Sugarsplash/ece-capstone/README.md

# ece-capstone
Intel sponsored irrigation project.
