Sugarsplash/ece-capstone/docs/presentation.pdf

# Smart Irrigation ECE Capstone

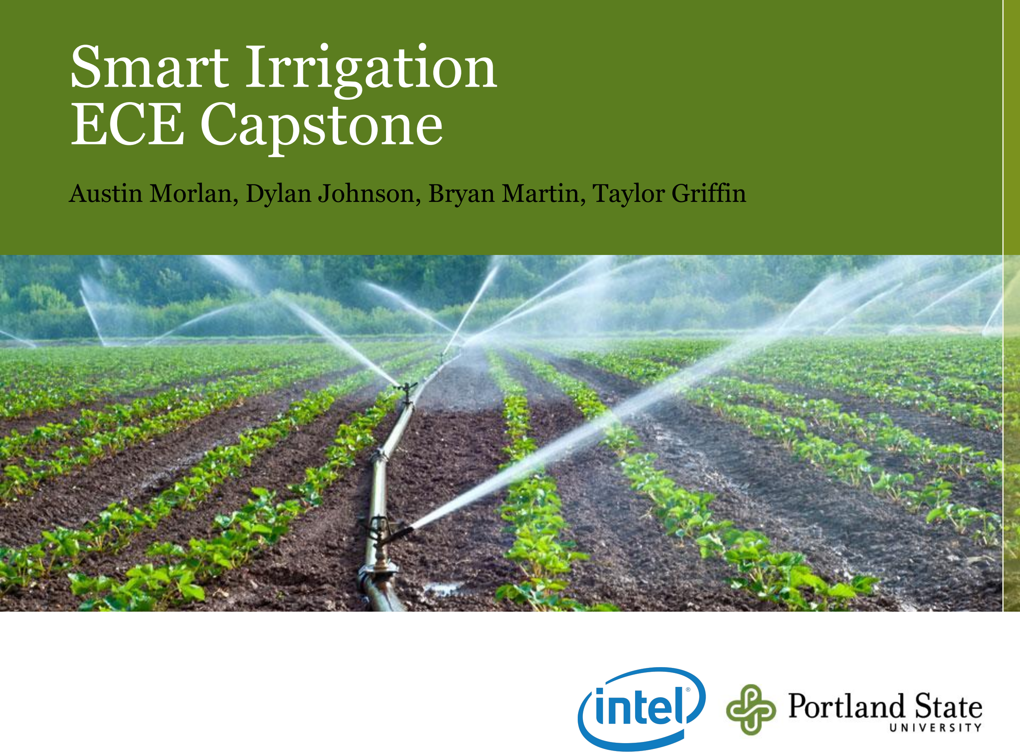
[picture p13: page 1]

Austin Morlan, Dylan Johnson, Bryan Martin, Taylor Griffin

# Problem

- Water is precious
- Current irrigation methods are wasteful
- Need more efficiency without lowering crop yield
- Existing irrigation controllers require:
- Frequent calibration
- Array of costly sensors
- Frequent sensor replacement

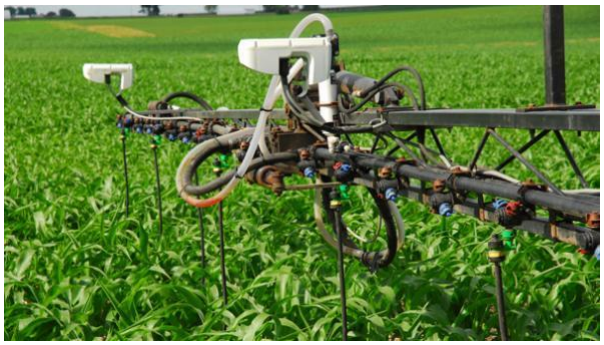
[picture p14: figure]

# Problem

### - There is a need for low cost, low maintenance controllers - Should work in any location, terrain, and local climate - Should contain few sensors for minimal cost

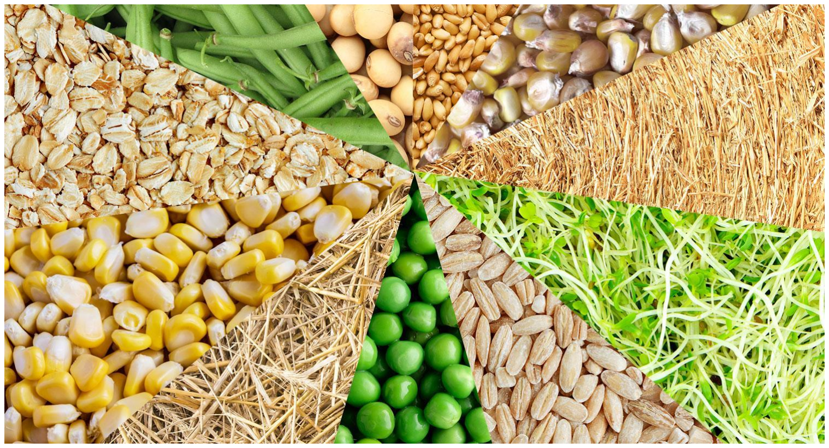
[picture p15: figure]

# Solution

- Water-budgeting & irrigation scheduling
- Tracks amount of water entering and leaving soil
- Evaporation of water from soil to environment
- Transpiration of water from crops to environment + Precipitation of water from environment to soil + Added water from water source

# Hargreaves Reduced-set Method

- Estimates evapotranspiration w/ ambient air temperature, latitude, and day of the year
- Requires two sensors: temperature and precipitation
- Latitude and calendar day supplied by app
- Calculates how much water has left soil
- Amount that has left is resupplied by water source

Irr - amount of water to be applied (mm) Eto - crop evapotranspiration (mm)
P - precipitation (mm)

# Device Technology

- MCU:
- BL600 - nRF51822 (Cortex M0) with smartBASIC added
- Sensors:
- Temperature, rain - for evapotranspiration algorithm
- Soil moisture - to check calculations against reality
- Flow - to measure amount of water distributed
- Enclosure
- Waterproof
- Snazzy

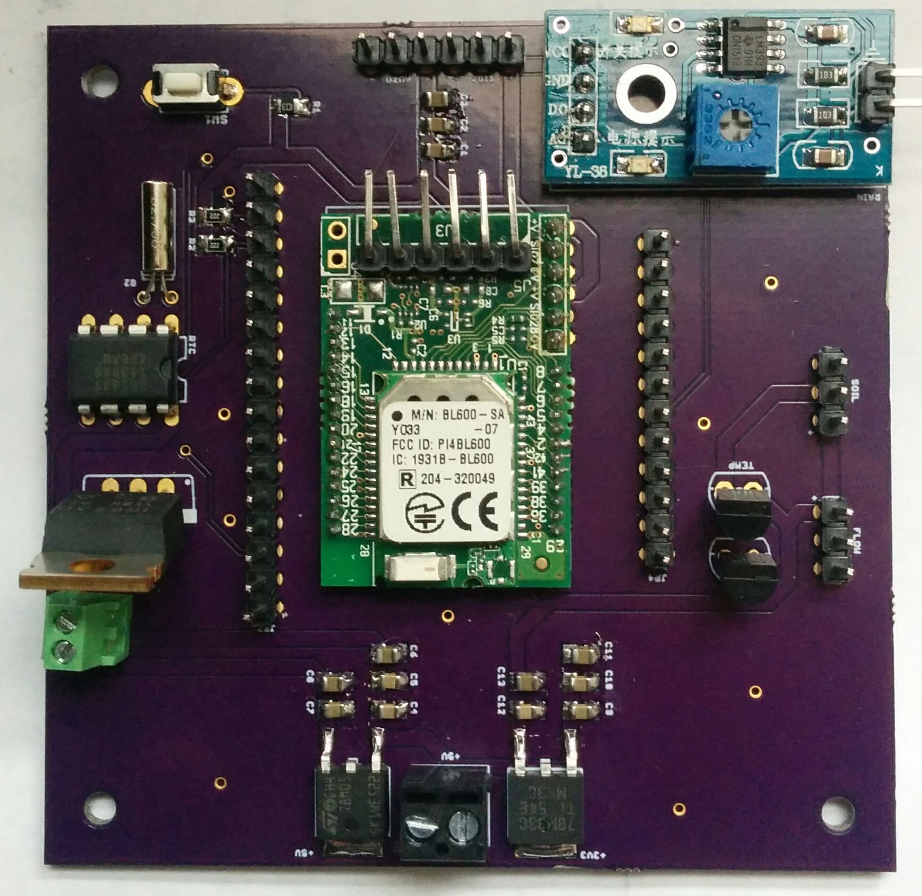
[picture p16: figure]

# Functionality Overview

- Samples temperature and precipitation sensors hourly
- Track wet or dry precipitation readings throughout day
- Eto calculations performed once per day with daily high and low temperature values
- Eto multiplied by crop area to find volume of water leaving soil
- Solenoid activated to actuate water flow
- Flow sensor calculates how much water has been distributed

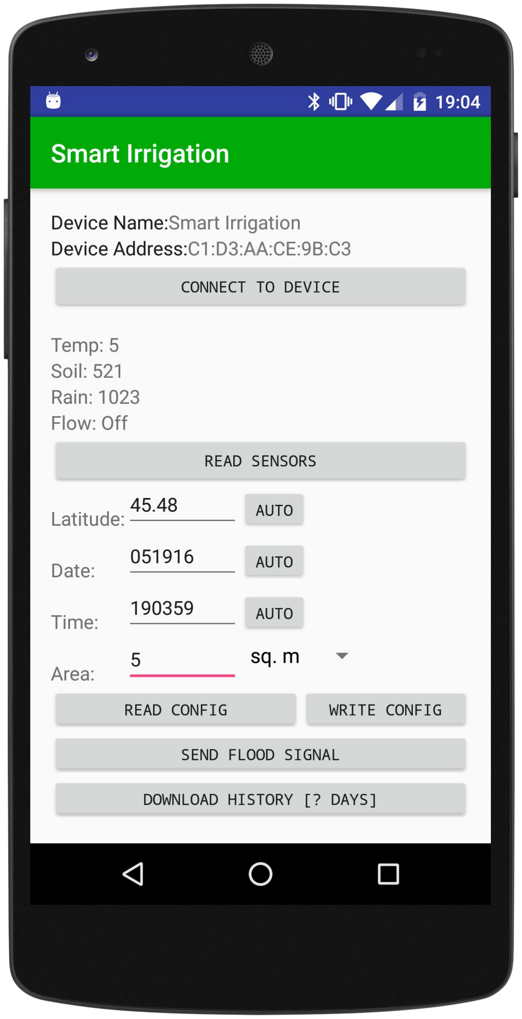
[picture p17: figure]

# Android App

- Communicates | with | device | via
Bluetooth Low-Energy (BLE)
- Sends configuration info for irrigation policy (time, date, latitude)
- Downloads 32 days of irrigation statistics (max temp, min temp, etc)
- Receives and displays live sensor readings

# Case Design

- Modeled in SolidWorks
- Laser cut in L.I.D.
- Ver. 1 built with ¼ inch clear cast acrylic
- Housed both the PCB and hose connections

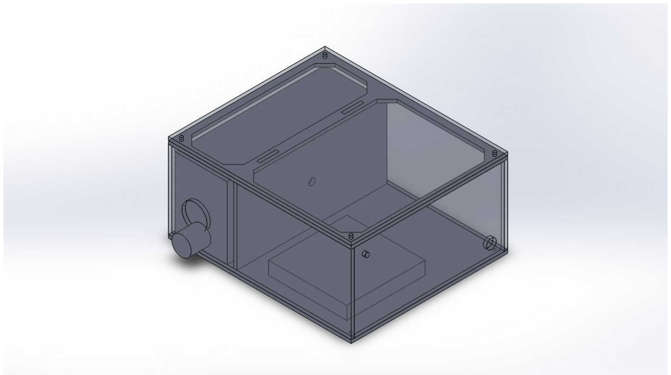
[picture p18: figure]

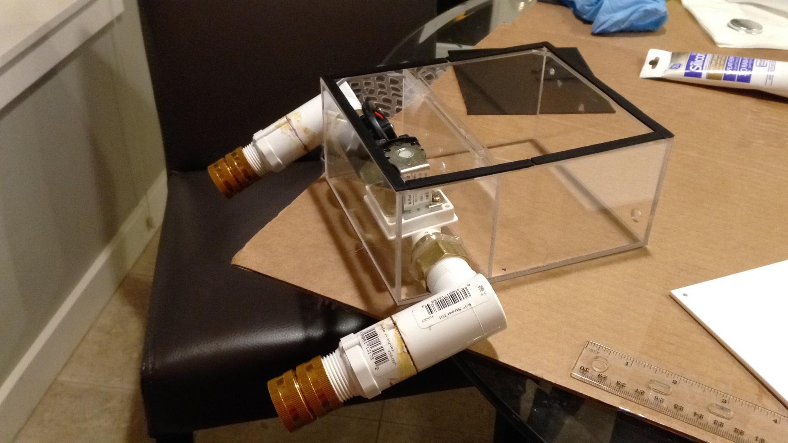
[picture p19: figure]

# Case Design

- Ver. 2 built with ¼ inch white cast acrylic
- Hose connections moved outside box

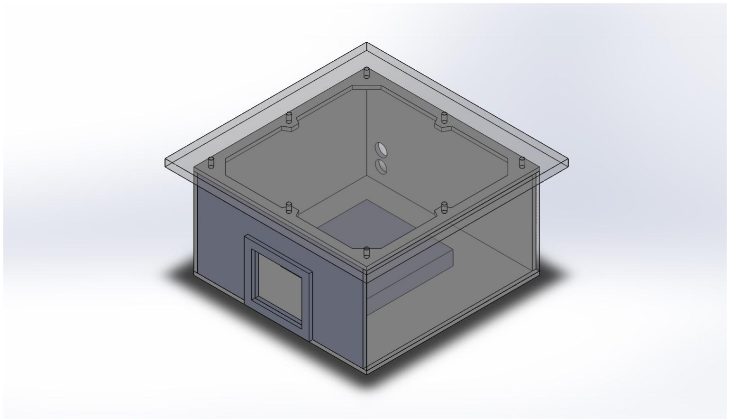
[picture p20: figure]

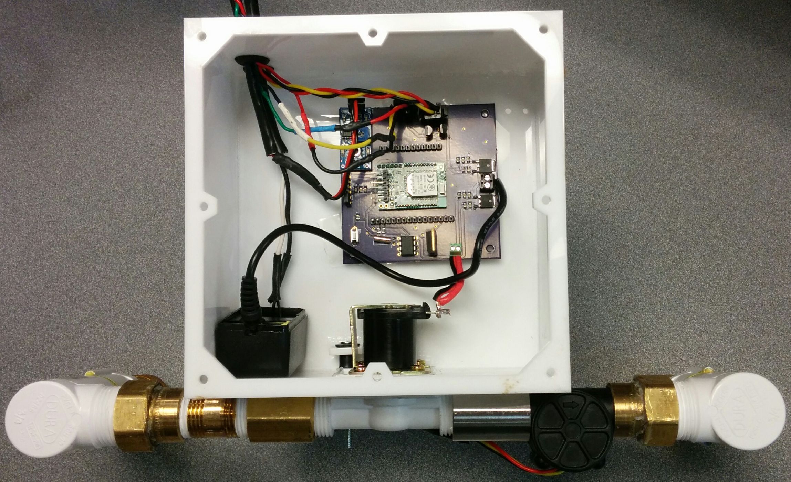
[picture p21: figure]
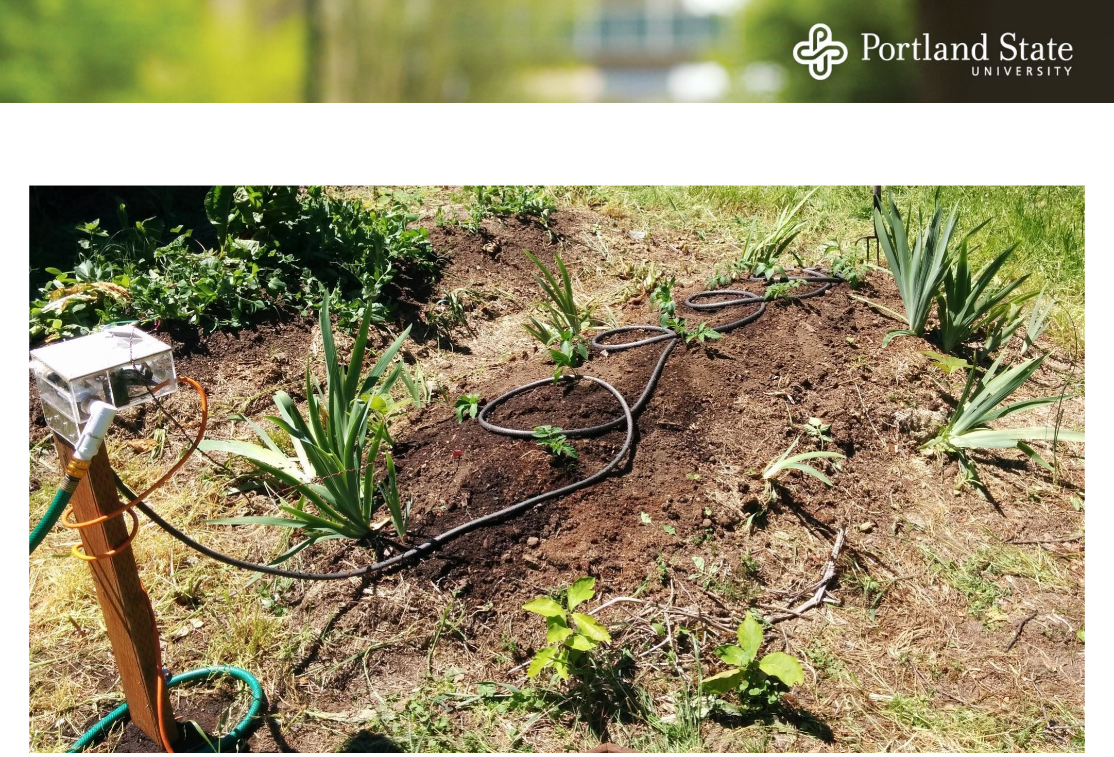
[picture p22: page 14]

# Results

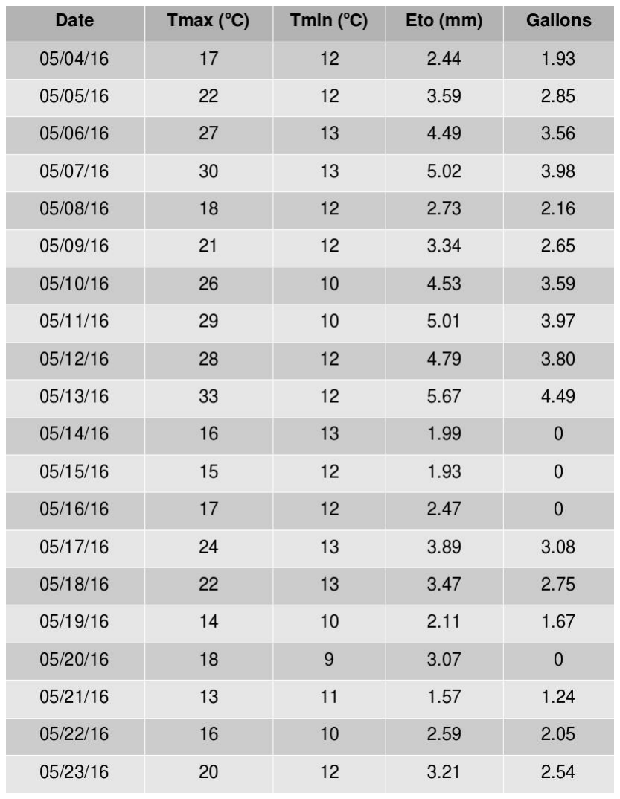
[picture p23: figure]

- Field tested from May 4th-23rd
- Area to be irrigated was 3m²
- Total evapotranspiration calculated at 67.91mm
- Irrigated 46.3 gallons total
- Precipitation provided 10.6 gallons
- Together: 56.9 gallons of water supplied to vegetable bed

# Historical/Rule of (Green) Thumb Comparison

- Historical
- 10-year evapotranspiration for Forest Grove, OR: 84.4mm
- Rule of Thumb:
- 1” of water per week
- Additional 0.5” of water per week for avg temp above 70 o F
- Using this: 63.4 gallons needed by either irrigation or rain

# Conclusions

- An overall success!
- Water-budgeting and evapotranspiration estimates work
- Compares favorably to historical data & rule of thumb guidelines
- Future Improvements:
- More testing data
- Sites varying in location, soil quality, and crops grown
- Possibly adjust constants in calculations
- Different rain detection

# References

1. FAO Irrigation and Drainage Paper 56
2. USGS, Oregon Water Science Center, HYDRA Rainfall Network
3. US Department of Interior, Bureau of Reclamation, Cooperative Agricultural Weather Network
4. Bonnie Plant Farm, “How Much Water Do Plants Need?”
