Sugarsplash/ece-capstone/enclosure/Box Rev 2.0/BOX.SLDASM

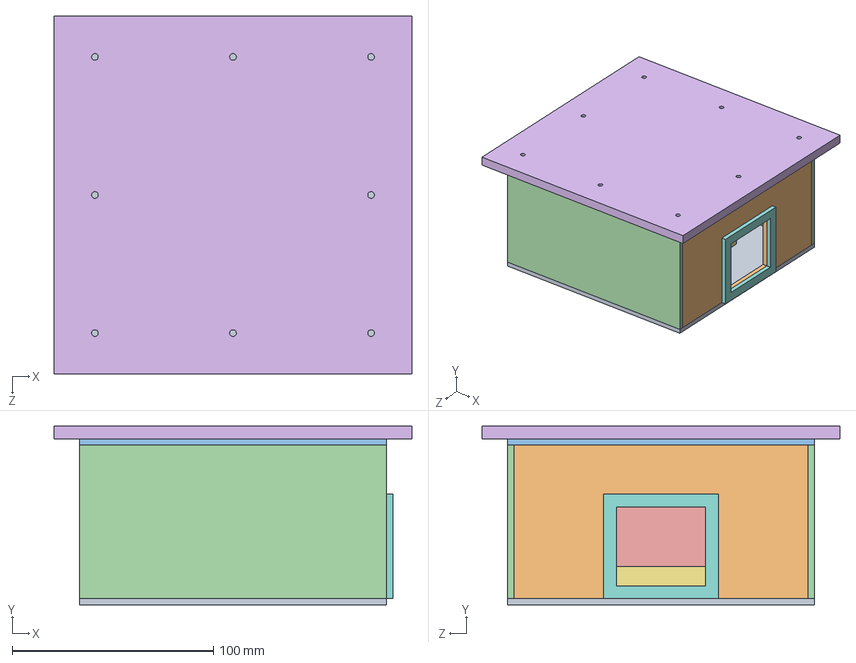
[picture p25: CAD file, 2016-05-24]
enclosure/Box Rev 2.0/BOX.SLDASM
177.8 x 88.9 x 177.8 mm
Bottom
FlowSide
Gasket
LongSide x 2
PowerSide
Top
PCB
Spacer
