Sugarsplash/ece-capstone/enclosure/Box.SLDASM

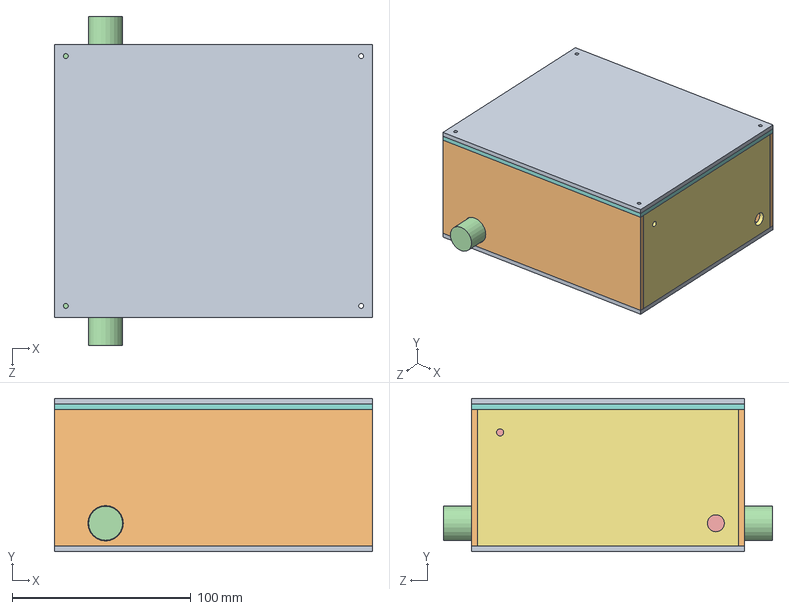
[picture p26: CAD file, 2016-05-18]
enclosure/Box.SLDASM
177.8 x 85.7 x 184.1 mm
Bottom x 2
ShortSides x 2
LongSides
WaterPipe
Divider
PCB
LongSidePower
Gasket
