Sugarsplash/ece-capstone/enclosure/Box Rev 2.0/Laser Cut This/PowerSide.DXF

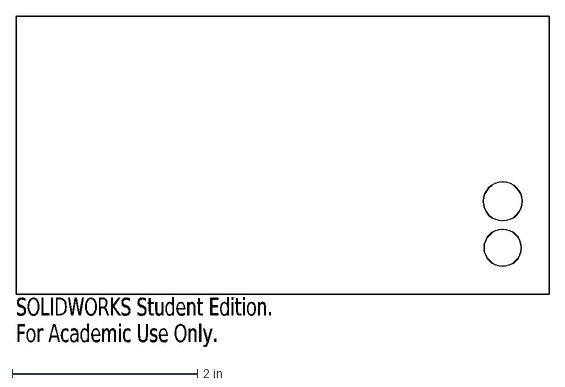
[picture p27: CAD file, 2016-05-24]
enclosure/Box Rev 2.0/Laser Cut This/PowerSide.DXF
SOLIDWORKS Student Edition.
For Academic Use Only.
