Sugarsplash/ece-capstone/enclosure/Box Rev 2.0/PowerSide.SLDPRT

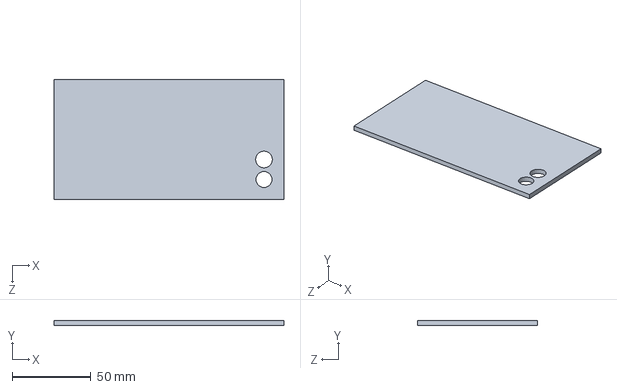
[picture p28: CAD file, 2016-05-24]
enclosure/Box Rev 2.0/PowerSide.SLDPRT
146.1 x 3.17 x 76.2 mm
