Sugarsplash/ece-capstone/enclosure/Laser Cut/LongSidePower.DXF

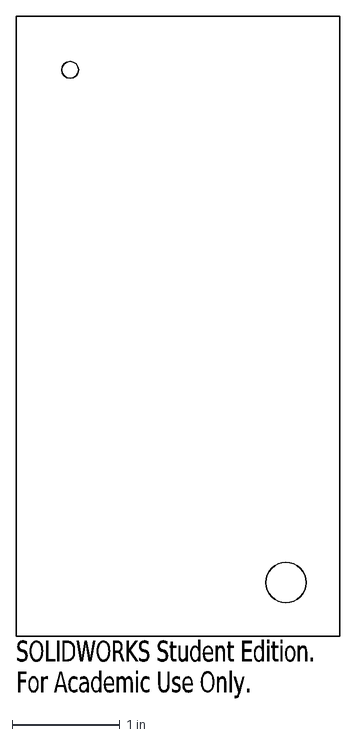
[picture p29: CAD file, 2016-05-18]
enclosure/Laser Cut/LongSidePower.DXF
SOLIDWORKS Student Edition.
For Academic Use Only.
