Sugarsplash/ece-capstone/enclosure/PCB.SLDPRT

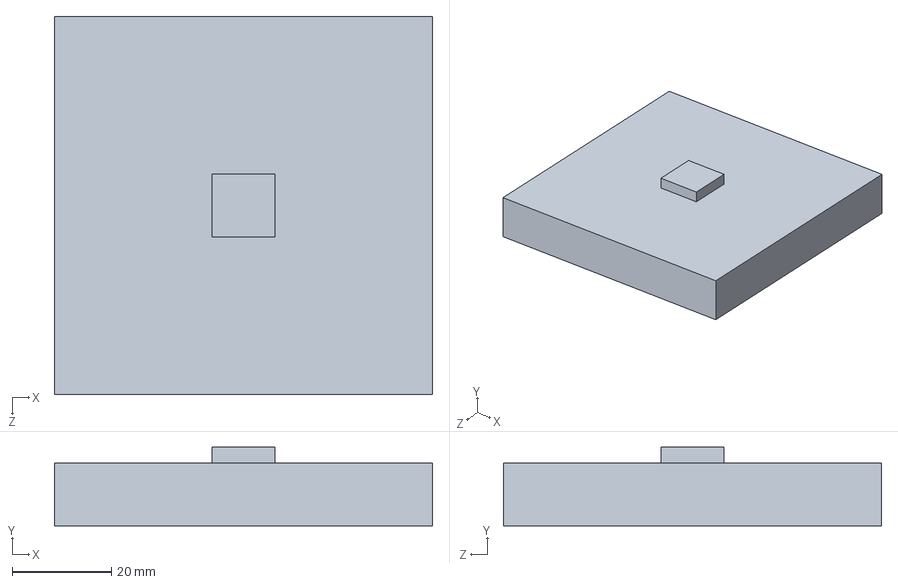
[picture p30: CAD file, 2016-05-18]
enclosure/PCB.SLDPRT
76.2 x 15.9 x 76.2 mm
