Sugarsplash/ece-capstone/enclosure/Cable.SLDPRT

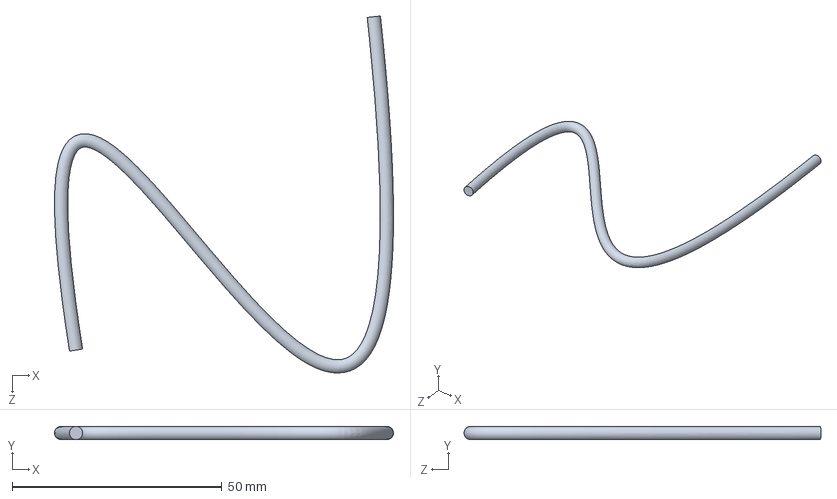
[picture p31: CAD file, 2016-05-18]
enclosure/Cable.SLDPRT
80.8 x 3.17 x 85.1 mm
