Sugarsplash/ece-capstone/enclosure/Laser Cut/Divider.DXF

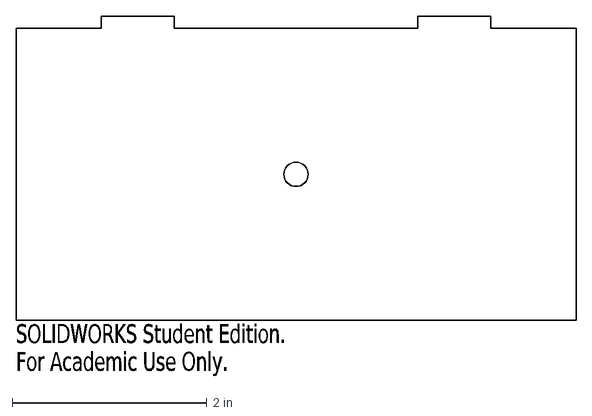
[picture p32: CAD file, 2016-05-18]
enclosure/Laser Cut/Divider.DXF
SOLIDWORKS Student Edition.
For Academic Use Only.
