Sugarsplash/ece-capstone/enclosure/Box Rev 2.0/Gasket.SLDPRT

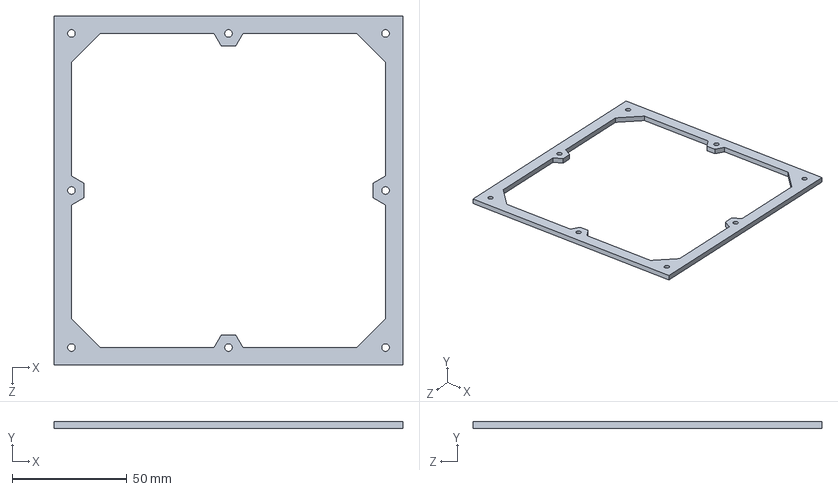
[picture p33: CAD file, 2016-05-24]
enclosure/Box Rev 2.0/Gasket.SLDPRT
152.4 x 3.17 x 152.4 mm
