Sugarsplash/ece-capstone/enclosure/Laser Cut/WhiteTop.DXF

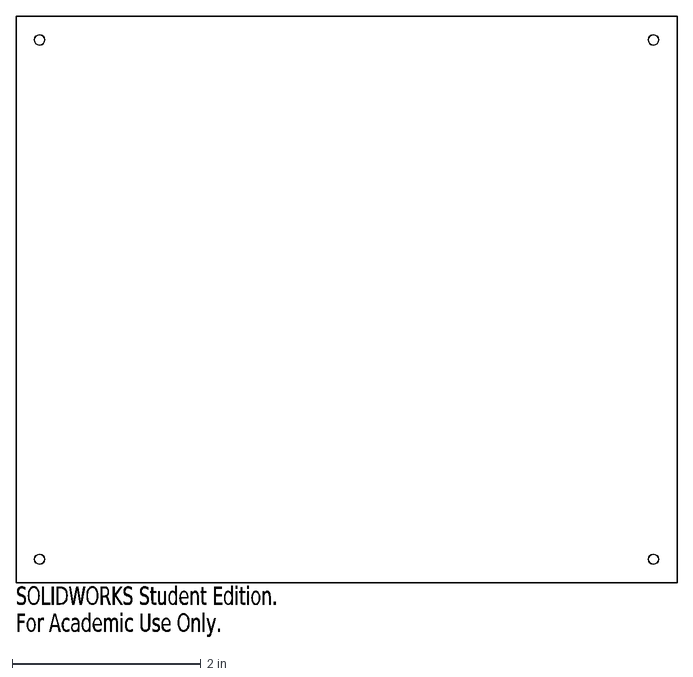
[picture p34: CAD file, 2016-05-18]
enclosure/Laser Cut/WhiteTop.DXF
SOLIDWORKS Student Edition.
For Academic Use Only.
