Sugarsplash/ece-capstone/enclosure/Box Rev 2.0/Spacer.SLDPRT

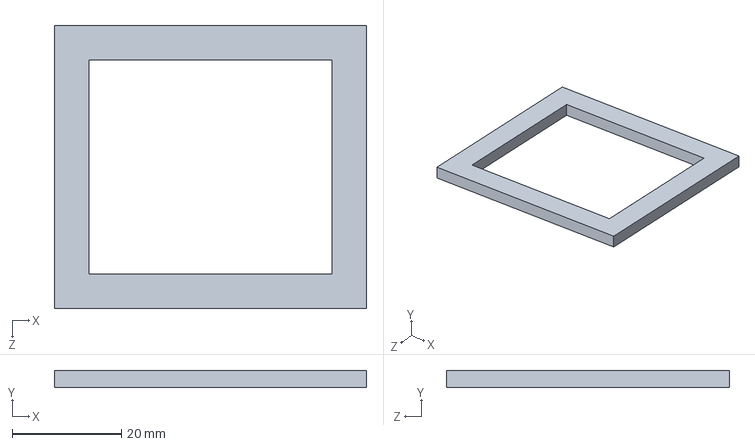
[picture p35: CAD file, 2016-05-24]
enclosure/Box Rev 2.0/Spacer.SLDPRT
57.1 x 3.17 x 51.9 mm
