Sugarsplash/ece-capstone/enclosure/Laser Cut/Gasket.DXF

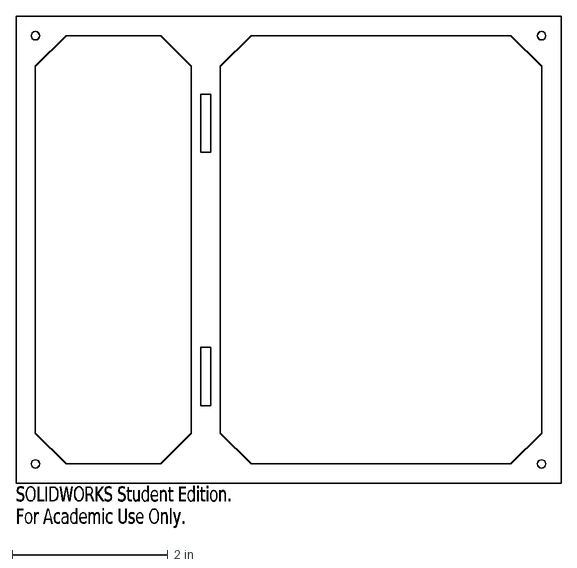
[picture p36: CAD file, 2016-05-18]
enclosure/Laser Cut/Gasket.DXF
SOLIDWORKS Student Edition.
For Academic Use Only.
