Sugarsplash/ece-capstone/enclosure/Laser Cut/ShortSides.DXF

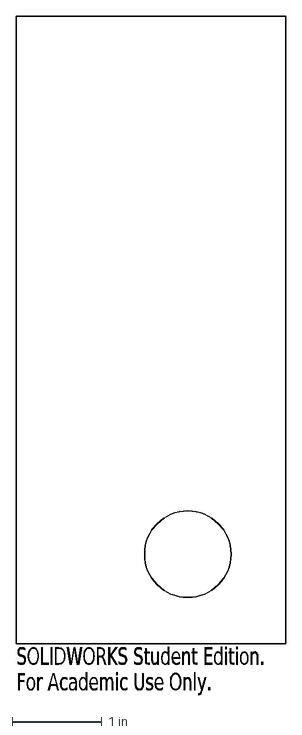
[picture p38: CAD file, 2016-05-18]
enclosure/Laser Cut/ShortSides.DXF
SOLIDWORKS Student Edition.
For Academic Use Only.
