Sugarsplash/ece-capstone/enclosure/ShortSides.SLDPRT

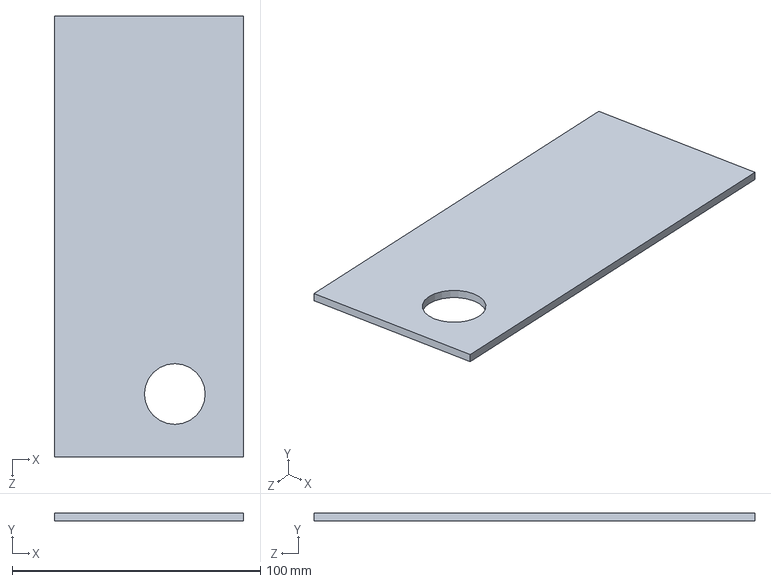
[picture p39: CAD file, 2016-05-18]
enclosure/ShortSides.SLDPRT
76.2 x 3.17 x 177.8 mm
