Sugarsplash/ece-capstone/enclosure/Box Rev 2.0/Top.SLDPRT

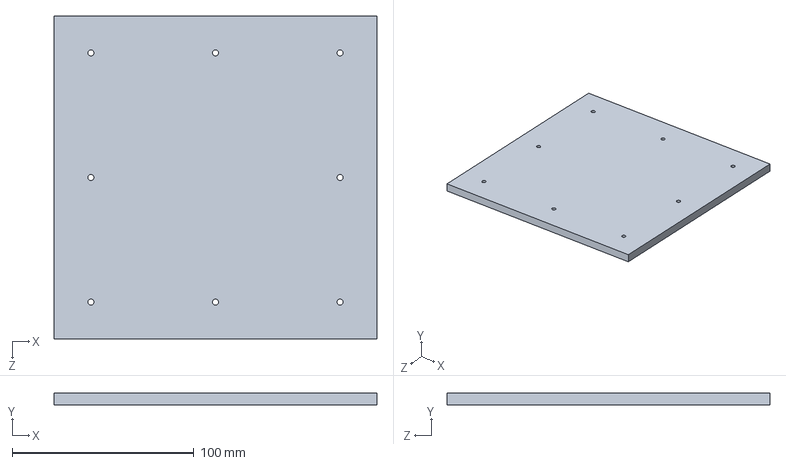
[picture p40: CAD file, 2016-05-24]
enclosure/Box Rev 2.0/Top.SLDPRT
177.8 x 6.35 x 177.8 mm
