Sugarsplash/ece-capstone/enclosure/Laser Cut/LongSides.DXF

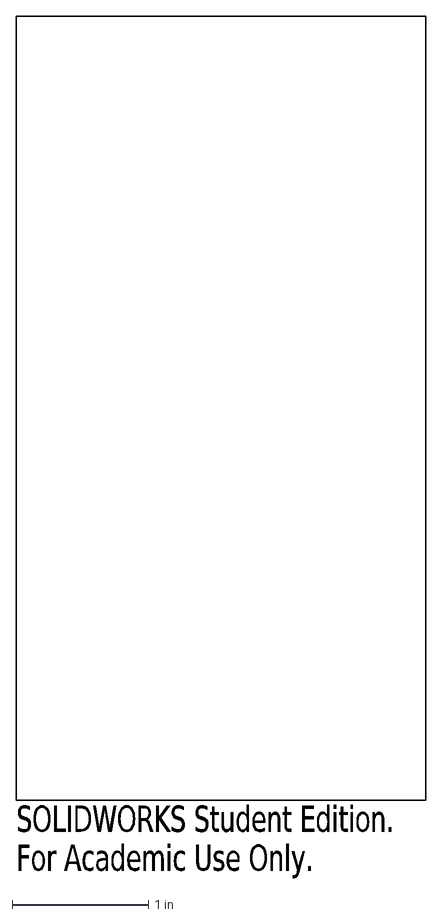
[picture p41: CAD file, 2016-05-18]
enclosure/Laser Cut/LongSides.DXF
SOLIDWORKS Student Edition.
For Academic Use Only.
