Sugarsplash/ece-capstone/enclosure/WhiteTop.SLDPRT

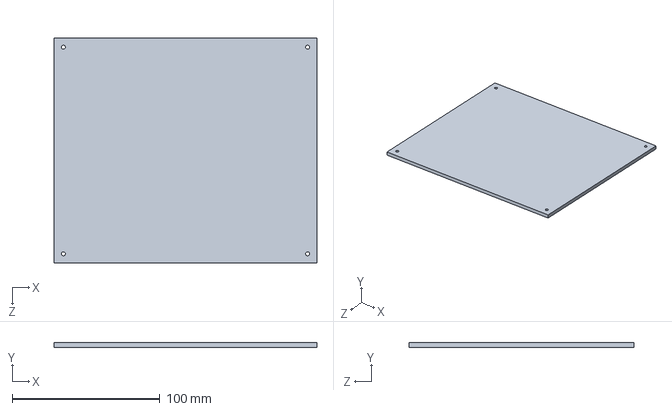
[picture p42: CAD file, 2016-05-18]
enclosure/WhiteTop.SLDPRT
177.8 x 3.17 x 152.4 mm
