Sugarsplash/ece-capstone/enclosure/Box Rev 2.0/LongSide.SLDPRT

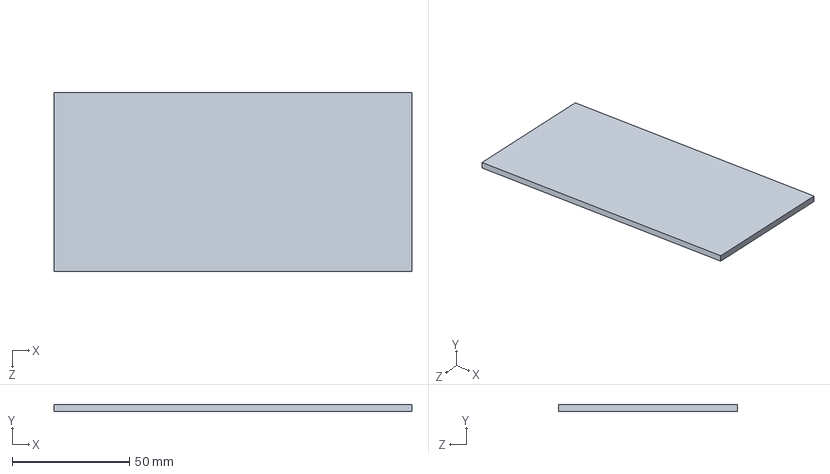
[picture p43: CAD file, 2016-05-21]
enclosure/Box Rev 2.0/LongSide.SLDPRT
152.4 x 3.17 x 76.2 mm
