Sugarsplash/ece-capstone/enclosure/Box Rev 2.0/Bottom.SLDPRT

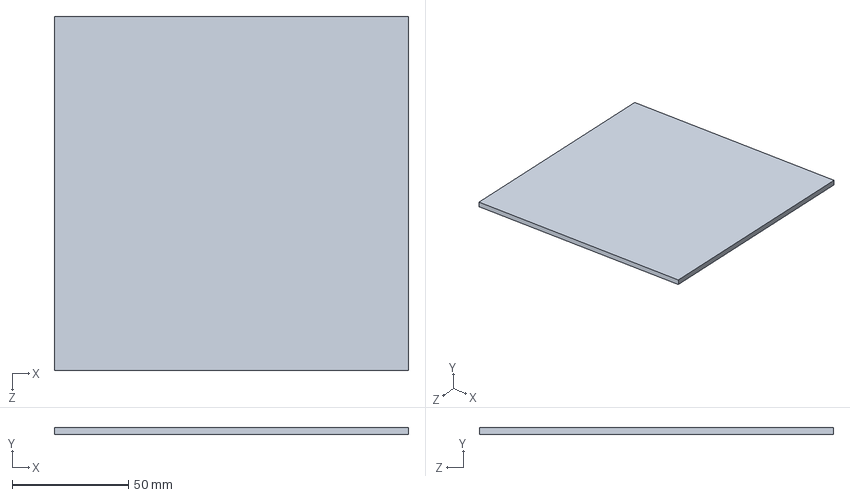
[picture p44: CAD file, 2016-05-21]
enclosure/Box Rev 2.0/Bottom.SLDPRT
152.4 x 3.17 x 152.4 mm
