Sugarsplash/ece-capstone/enclosure/LongSides.SLDPRT

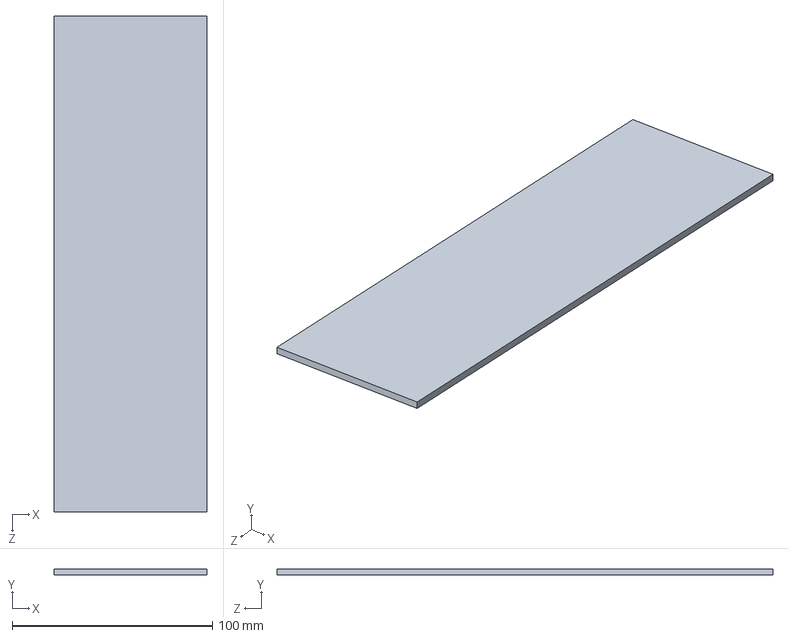
[picture p45: CAD file, 2016-05-18]
enclosure/LongSides.SLDPRT
76.2 x 3.17 x 247.6 mm
