Sugarsplash/ece-capstone/enclosure/Divider.SLDPRT

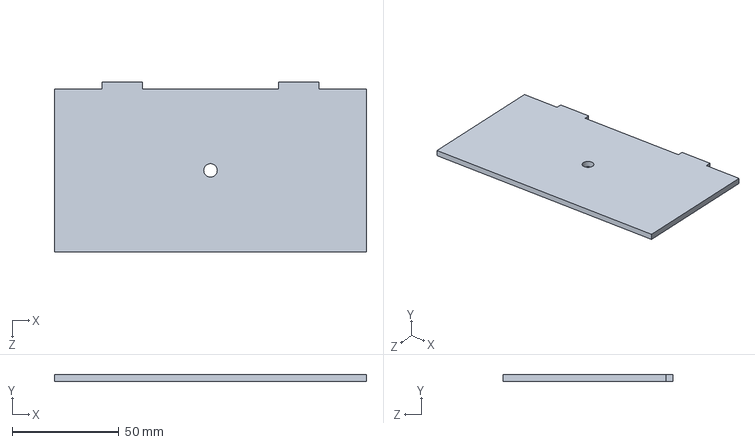
[picture p46: CAD file, 2016-05-18]
enclosure/Divider.SLDPRT
146.1 x 3.17 x 79.4 mm
