Sugarsplash/ece-capstone/enclosure/WaterPipe.SLDPRT

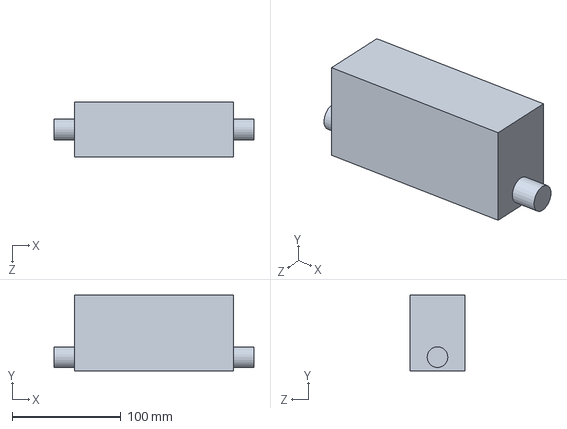
[picture p47: CAD file, 2016-05-18]
enclosure/WaterPipe.SLDPRT
184.1 x 69.8 x 50.8 mm
