Sugarsplash/ece-capstone/enclosure/Gasket.SLDPRT

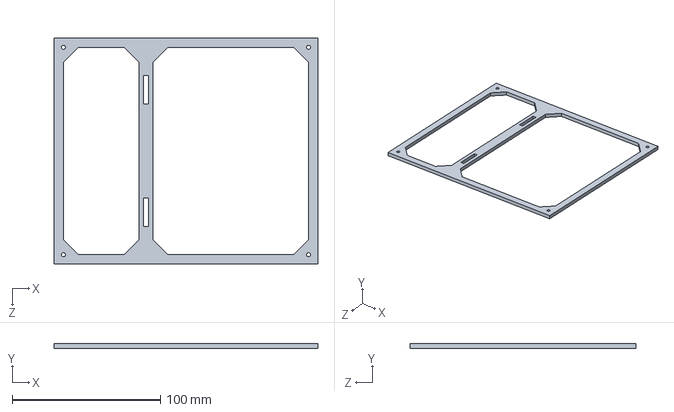
[picture p48: CAD file, 2016-05-18]
enclosure/Gasket.SLDPRT
177.8 x 3.17 x 152.4 mm
