Sugarsplash/ece-capstone/(list of files, cad)

Other CAD files:
enclosure/LongSidePower.SLDPRT
enclosure/Bottom.SLDPRT
