Sugarsplash/ece-capstone/docs/algorithm_logbook.pdf

# Engineering Logbook

## Senior Capstone - Portland State University

# Bryan Martin

## bryan3@pdx.edu

## Beginning 4 January 2016

# Contents

Monday, 4 January 2016 | 1
Wednesday, 6 January 2016 | 2
Saturday, 9 January 2016 | 3
2 | Comparison of Historical Evapotranspiration Data and Hardgreaves Ap-
Tuesday, 26 January 2016 | 5
Sunday, 7 February 2016 | 6

iii

# Monday, 4 January 2016

## 1 Irrigation Policy - Research Summary

Water balancing method of irrigation scheduling appears suitable for computational methods and requires no field work.¹
Water balancing accounting is performed by calculating how much water leaves the soil and how much water is absorbed by the soil. Moisture can leave the soil through the following mechanisms:
- Evapotranspiration (Etc):
1. Moisture leaves the soil to the surrounding air.
2. Water is absorbed by the plants.
- Surface Runoff (SRO): Runoff occurs when irrigation or rainwater is applied at a rate faster than the soil can absorb.
- Deep Percolation (DP): Drainage of water away from the root zone

Water enters the soil through the precipitaion, irrigation, or upwelling. (P, Irr, U) If these terms can be estimated, a water deficit can be calulated by:

D = Etc − P − Irr − U + SRO + DP 2

The goal of our device will be to restore water lost from the soil by irrigating the correct amount so as to correct the water deficit. We can simplify the equation above by assuming the SRO and DP terms to be negligible. This requires the delivery of water via irrigation to not exceed the rate of uptake by the soil. The application rate will be determined outside of this system. U will be assumed to be negligible as well. Irrigation will be set equal to the deficit, leaving the resulting equation:

Irr = D = Etc − P

This approach will require a method to estimate Etc and precipitation. Can we skip a day if precipitation is detected? Can we detect precipitation using sensors for determining evapotranspiration? Humidity perhaps?

1CSUE Fact Sheet No. 4708
2CSUE Fact Sheet No. 4707

1

# Wednesday, 6 January 2016

## 1 Etc Estimations

Etc = Eto · Kc · Ks

1

Where Eto is a reference evaportranspiration rate, Kc is the crop specific coefficient, and Ks is the crop stress coefficient. This equation will be simplified by setting both coefficients equal to 1, resulting:

Etc = Eto

Eto is usually determined by following the Penman-Montieth method.² Since this method requires many environmental vashowsriables, it is not suitable for our application. In-stead, a reduced set method such as Hardgreaves(HARG)³ will be used. HARG:

EtoH = HC · Ra · (Tmax − Tmin)

HE · (

Tmax + Tmin
2

+ HT)

HC, HE, and HT are all constants that can be calibrated. The Hardgreaves method requires only ambient air temperature and calendar day since Ra can be supplied from meteorological data given date and latitude. At this point we can determine Irrigation (Irr) needed with the following:

- Calendar Day (Requires Table of Ra stored in memory)
- Maximum/Minimum Ambient Temperature (Daily?)
- Precipitaion (Sensing Pad?, Humidity?)

1CSUE Fact Sheet No. 4707
2FAO Irrigation and Drainage Paper 56
3Hardgreaves and Other Reduced-Set Methods for Calculating Evapotranspiration

2

# Saturday, 9 January 2016

## 1 Ra Estimations

The Hardgreaves method requires the extraterestrial radiation(Ra) in mm/day. In order to calculate this term we can use methods outlined in Chapter 3 of FAO-56 (Allen, 1998). Using latitude in radians and calendar day Ra can be calculated by:

Ra =

24(60)
π
- 0.082 · 0.408 · dr[ωssin(j)sin(d) + cos(j)cos(d)sin(ωs)]

Where
dr = 1 + 0.033cos(

2π
365
- Dy)

and

d = 0.409sin(

2π
365
- Dy − 1.39)

and

ωs = arccos(−tan(j)tan(d))

Where Dy = day of the year (1-365) and j = latitude in radians.
With this calculation, the table of radiation values mentioned previously will not be needed.

## 2 Comparison of Historical Evapotranspiration Data and Hardgreaves Approximation

Now an algorithm can be clearly stated that will determine the water lost from soil in mm/day. Given day of the year(Dy), latitude in radians(j), maximum daily temperature(Tmax), and minimum daily temperature(Tmin):

1. Calculate dr
2. Calculate d
3. Calculate ωs
4. Calculate Ra
5. Calculate Eto

3

Saturday, 9 January 2016

In order to see if this algorthm shows any promise I wanted to compare the output with historical data from the Portland area. The only data I found was for Aurora, Oregon. I used historical records of average monthly high and low temperatures for Portland, OR, and used a latitude of 45.5 degrees.

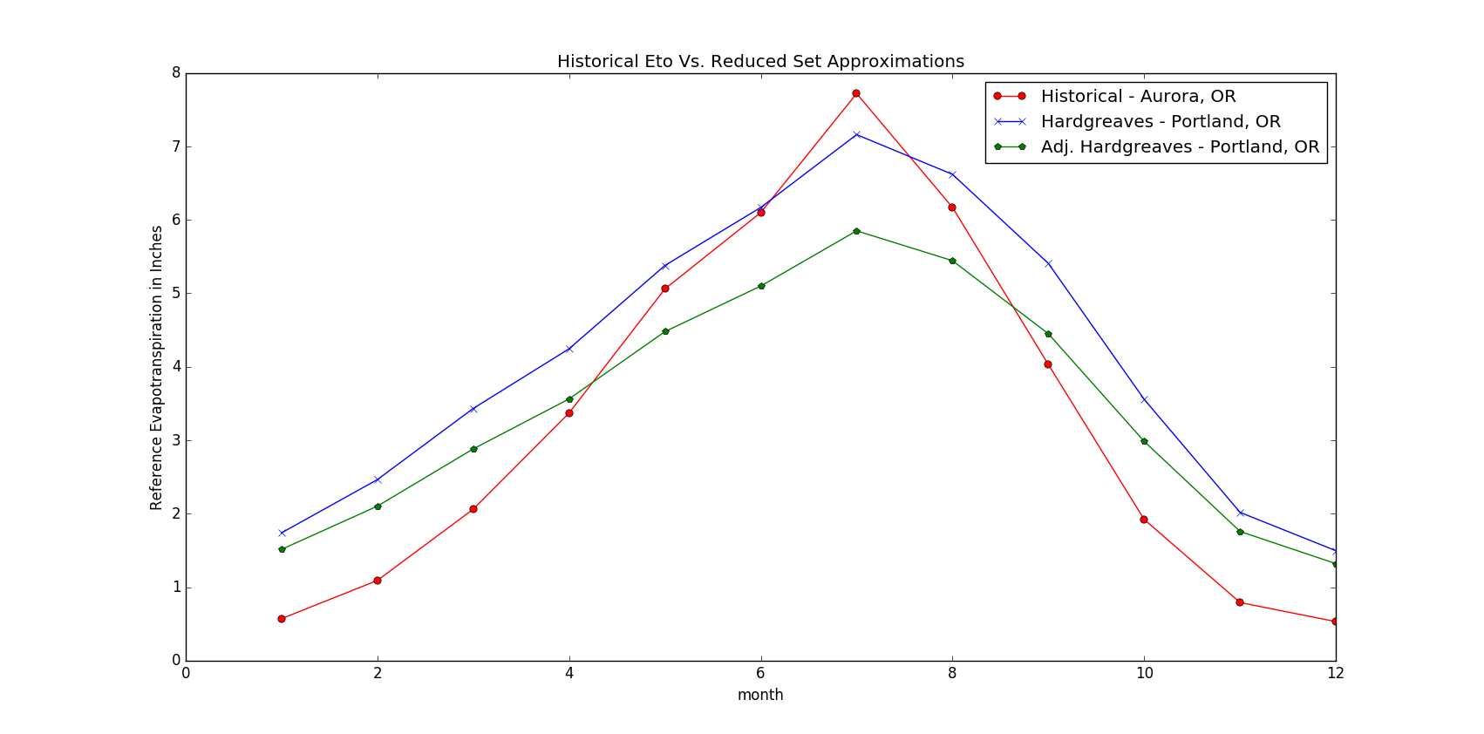
[picture p49: figure]

Figure 2 Historical Evapotranspiration Comparision with Hardgreaves Method The Hardgreaves approximation tracks well with the historical data, especially considering the differences in location and temperature data. I believe this figure shows that this algorithm is suitable for future consideration.

4

# Tuesday, 26 January 2016

## 1 Main Component List

As a team we have selected and ordered the components in our system design model.

- Laird BL600 eBOB
- Raindrop Sensor
- Temperature Sensor - TMP36
- Real Time Clock - DS1307
- 32.7 MHz Crystal
- 1/2” Water Flow Solenoid
- 1/2” Water Flow Sensor
- Soil Moisture Sensor

5

# Sunday, 7 February 2016

## 1 Water Delivery Build and Test

Today Austin, Taylor and I assembled the water system in order to test the solenoid, flow sensor, and BL600 eBOB. The system was constructed using:

- 1/2” Water Flow Solenoid
- 1/2” Water Flow Sensor
- Brass 3/4” Female to 1/2” male adapter x2
- Plastic 1/2” Female coupler
- 9VDC 1A Switching AC power adapter

Using GPIO input on the BL600, we tested the accuracy of the flow sensor and tested the system for water leaks.
Results:

6

# Sources

7
