Sugarsplash/ece-capstone/pcb/smart_irrigation.brd

## EAGLE design pcb/smart_irrigation.brd (2016-04-23)

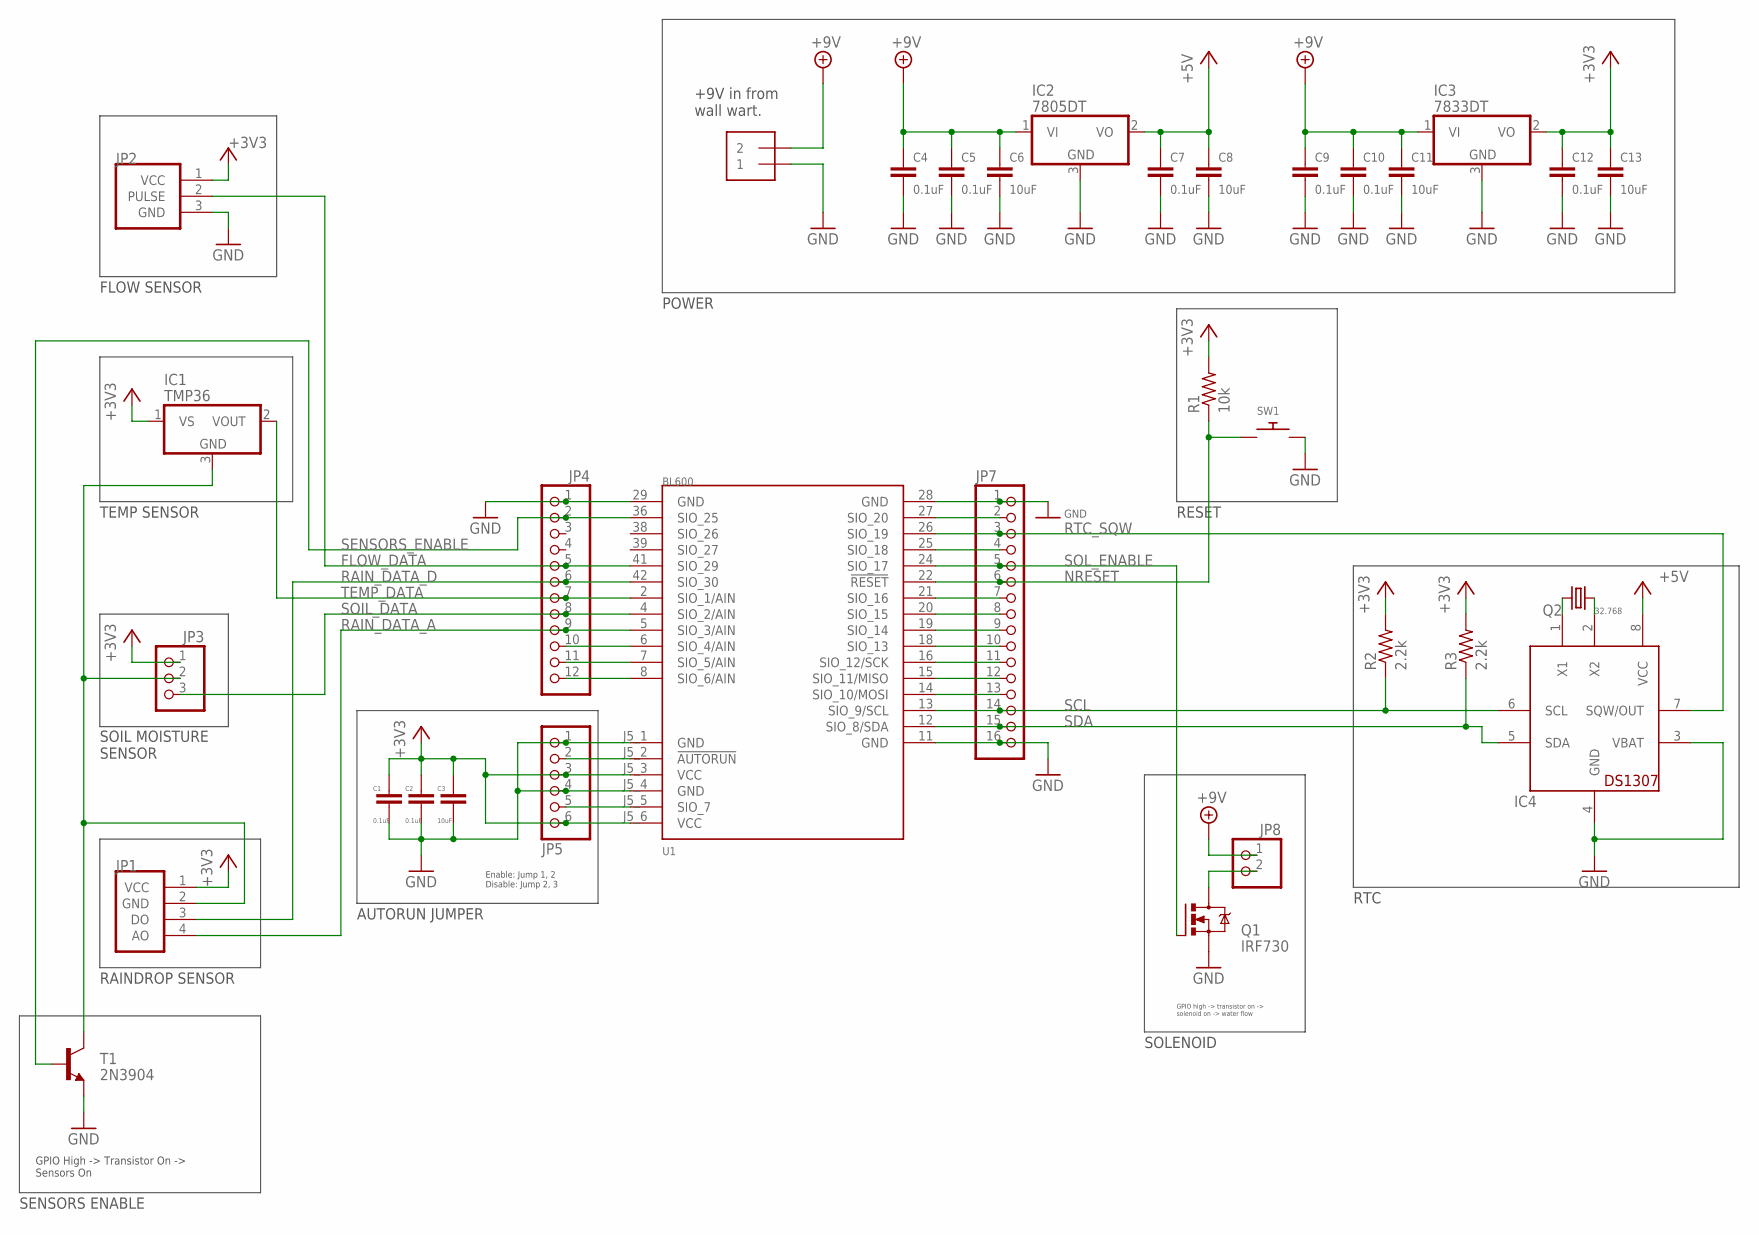
[picture p50: schematic smart_irrigation.sch]

Parts:
C1, C2, C4, C5, C7, C9, C10, C12: 0.1uF; C0805
C3, C6, C8, C11, C13: 10uF; C0805
IC1: TMP36; TO92
IC2: 7805DT; TO252
IC3: 7833DT; TO252
IC4: DS1307; DIL08
JP1: RAINDROP; 1X04
JP2: FLOW; 1X03
JP3: PINHD-1X3; 1X03
JP4: PINHD-1X12; 1X12
JP5: PINHD-1X6; 1X06
JP6: 1X2-3.5MM
JP7: PINHD-1X16; 1X16
JP8: PINHD-1X2; 1X02
Q1: IRF730; TO220
Q2: 32.768; TC38H
R1: 10k; M0805
R2, R3: 2.2k; M0805
SW1: SWITCH_PUSHBUTTONEVQ-PE; TACT_PANA-EVQ
T1: 2N3904; TO92
U1: BL600; BOB

Connections:
3V3_TRAN_COL: IC1.3 (GND), JP1.2 (GND), JP3.2, T1.1 (C)
+3V3: C1.1, C2.1, C3.1, C12.1, C13.1, IC1.1 (VS), IC3.2 (VO), JP1.1 (VCC), JP2.1 (VCC), JP3.1, JP5.3, JP5.6, R1.2, R2.2, R3.2, U1.J5_3 (VCC), U1.J5_6 (VCC)
+5V: C7.1, C8.1, IC2.2 (VO), IC4.8 (VCC)
+9V: C4.1, C5.1, C6.1, C9.1, C10.1, C11.1, IC2.1 (VI), IC3.1 (VI), JP6.2, JP8.1
FLOW_DATA: JP2.2 (PULSE), JP4.5, U1.41 (SIO_29)
GND: C1.2, C2.2, C3.2, C4.2, C5.2, C6.2, C7.2, C8.2, C9.2, C10.2, C11.2, C12.2, C13.2, IC2.3 (GND), IC3.3 (GND), IC4.3 (VBAT), IC4.4 (GND), JP2.3 (GND), JP4.1, JP5.1, JP5.4, JP6.1, JP7.1, JP7.16, Q1.S, SW1.P$2, T1.3 (E), U1.11 (GND), U1.28 (GND), U1.29 (GND), U1.J5_1 (GND), U1.J5_4 (GND)
unnamed: IC4.1 (X1), Q2.2
unnamed: IC4.2 (X2), Q2.1
NAUTORUN: JP5.2, U1.J5_2 (!AUTORUN)
NRESET: JP7.6, R1.1, SW1.P$1, U1.22 (!RESET)
RAIN_DATA_A: JP1.4 (AO), JP4.9, U1.5 (SIO_3/AIN)
RAIN_DATA_D: JP1.3 (DO), JP4.6, U1.42 (SIO_30)
RTC_SQW: IC4.7 (SQW/OUT), JP7.3, U1.26 (SIO_19)
SCL: IC4.6 (SCL), JP7.14, R2.1, U1.13 (SIO_9/SCL)
SDA: IC4.5 (SDA), JP7.15, R3.1, U1.12 (SIO_8/SDA)
SENSORS_ENABLE: JP4.2, T1.2 (B), U1.36 (SIO_25)
SIO_4: JP4.10, U1.6 (SIO_4/AIN)
SIO_5: JP4.11, U1.7 (SIO_5/AIN)
SIO_6: JP4.12, U1.8 (SIO_6/AIN)
SIO_7: JP5.5, U1.J5_5 (SIO_7)
SIO_10/MOSI: JP7.13, U1.14 (SIO_10/MOSI)
SIO_11/MISO: JP7.12, U1.15 (SIO_11/MISO)
SIO_12/SCK: JP7.11, U1.16 (SIO_12/SCK)
SIO_13: JP7.10, U1.18 (SIO_13)
SIO_14: JP7.9, U1.19 (SIO_14)
SIO_15: JP7.8, U1.20 (SIO_15)
SIO_16: JP7.7, U1.21 (SIO_16)
SIO_18: JP7.4, U1.25 (SIO_18)
SIO_20: JP7.2, U1.27 (SIO_20)
SOIL_DATA: JP3.3, JP4.8, U1.4 (SIO_2/AIN)
SOL_DRAIN: JP8.2, Q1.D
SOL_ENABLE: JP7.5, Q1.G, U1.24 (SIO_17)
TEMP_DATA: IC1.2 (VOUT), JP4.7, U1.2 (SIO_1/AIN)

Notes on the sheet:
+9V in from wall wart.
POWER
Enable: Jump 1, 2 Disable: Jump 2, 3
AUTORUN JUMPER
RTC
TEMP SENSOR
SOIL MOISTURE SENSOR
RAINDROP SENSOR
SOLENOID
GPIO high -> transistor on -> solenoid on -> water flow
SENSORS ENABLE
GPIO High -> Transistor On -> Sensors On
FLOW SENSOR
RESET

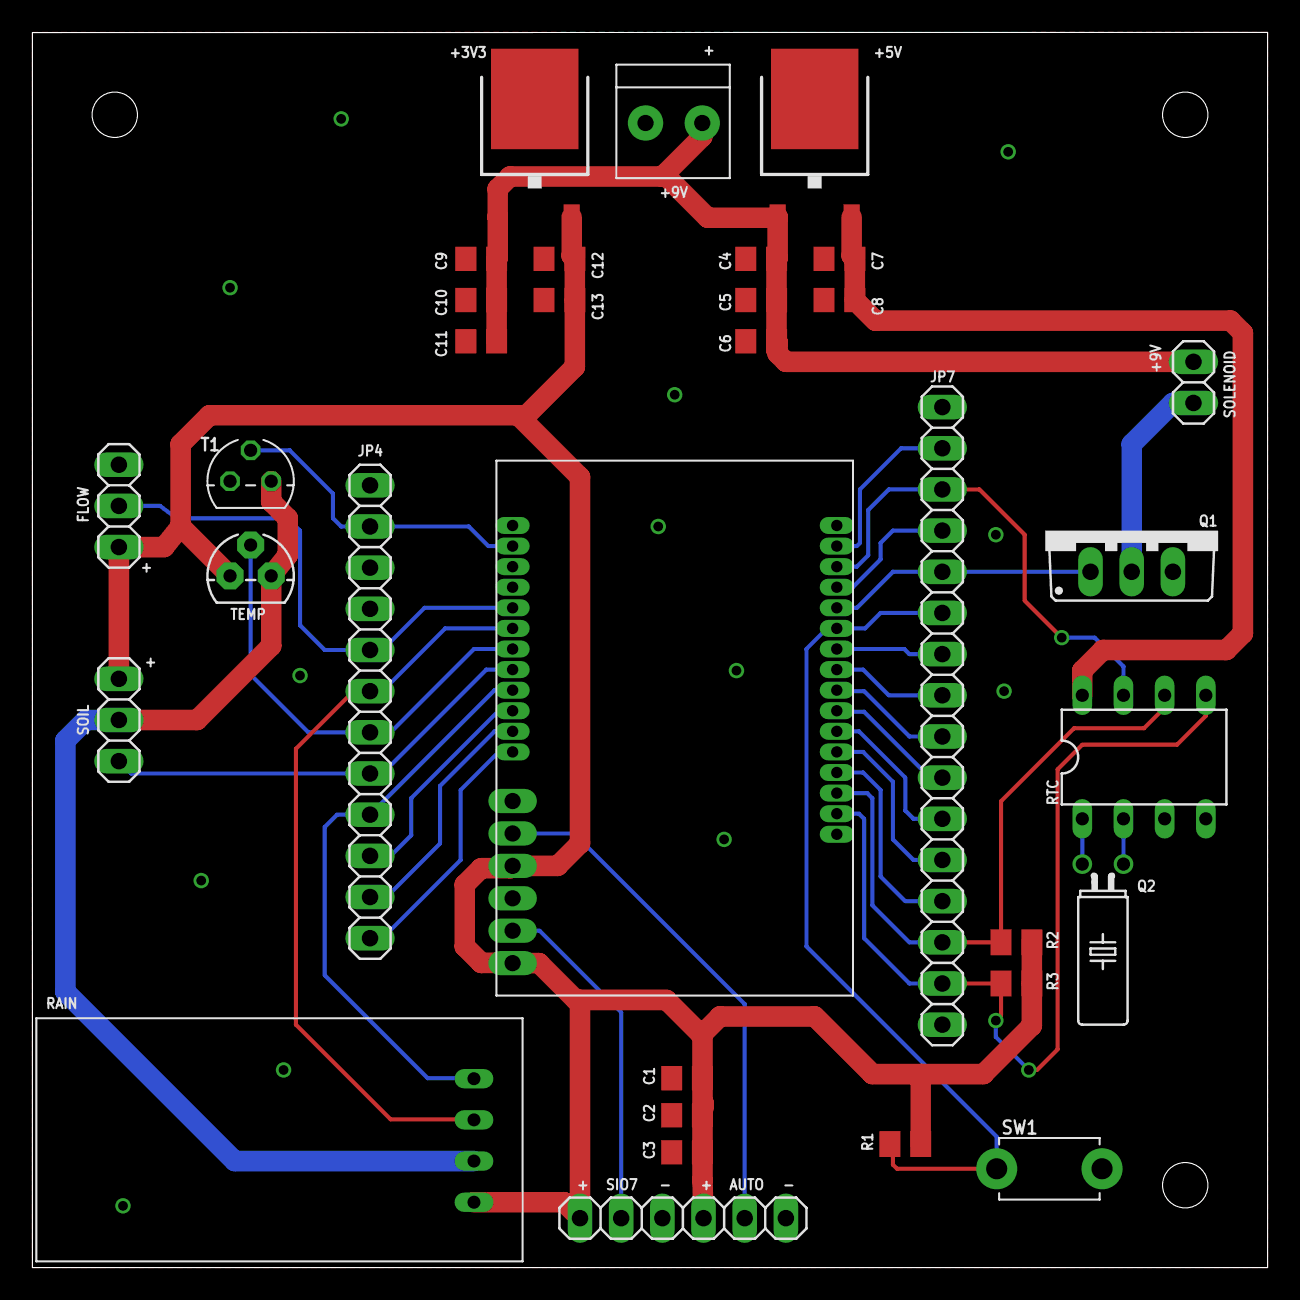
[picture p51: board smart_irrigation.brd from above]

Board: 2 copper layers, 76.2 x 76.2 mm, 33 parts (0 on the bottom side), 33 nets.
