Sugarsplash/ece-capstone/(commit log)

2016-01-15 Article and code for BL600 module
    This folder contains the Elektor magazine articles and source code for
    the BL600-eBoB. The BL600_eBoB is a breakout board for the Laird
    Technology Bluetooth LE communication module.
2016-02-01 Add original black box diagrams for solenoid and flow sensor.
2016-02-02 Replace deleted black box diagram
    Accidentally overwrote the temperature sensor diagram.
2016-02-08 Add src directory and flowTst.sb
2016-02-10 Add timeline and temperature test files.
    [timeline.ods]
2016-02-15 Add code to test solenoid circuit.
2016-02-15 Add schematic to timeline
    [timeline.ods]
2016-02-15 Add temperature sensor block diagram
2016-02-17 Remove sponsor materials zip
2016-02-18 App: Implement Get button for Latitude
    Latitude can be automatically retrieved if desired rather than entered manually.
2016-02-18 App: Remove settings button
2016-02-18 App: Implement Get button for Date
    Date can be automatically retrieved if desired rather than entered
    manually.
2016-02-23 Change RTC in design docs to 5V VCC
2016-02-23 Add meeting notes. Modified timeline
    [timeline.ods]
2016-02-23 Add datasheet for temperature sensor
2016-02-24 Add initial schematic
    [Design_Schematic.sch]
2016-02-29 LDO Voltage Regulator Datasheet
2016-02-29 Text File of Regulators
2016-03-01 Update timeline.
    [timeline.ods]
2016-03-05 Updated schematic. Added connections
    [Design_Schematic.sch]
2016-03-18 Initial BLE routine
    Skeleton for BLE routine sets up the BLE framework, configures status
    LEDs and advertising button, and is configured to be able to receive
    data: date, latitude, area.
2016-03-22 Updated wiring
    [Design_Schematic.sch]
2016-03-23 Rename "schematic" dir to "pcb"
    [Design_Schematic.sch]
2016-03-23 Add initial PCB files with power supply
    [smart_irrigation.brd, smart_irrigation.sch]
2016-03-23 Remove programming pins from BL600 device
    The pins will have a header soldered onto them directly which will not
    be soldered onto the PCB itself.
2016-03-23 Add BL600 with autorun jumper to PCB
    The autorun jumper is used to enable and disable the autorun feature of
    the BL600.
    [smart_irrigation.brd, smart_irrigation.sch]
2016-03-23 Rename EAGLE library file
    Schematic and board files updated to use new library filename
    [smart_irrigation.brd, smart_irrigation.sch]
2016-03-23 PCB: Add external headers
    Having the breakout board pins run to external headers allows for both
    debugging and adding additional peripherals if needed.
    [smart_irrigation.brd, smart_irrigation.sch]
2016-03-23 PCB: Add RTC
    [smart_irrigation.brd, smart_irrigation.sch]
2016-03-23 PCB: Add temp sensor
    [smart_irrigation.brd, smart_irrigation.sch]
2016-03-23 PCB: Add soil moisture sensor
    [smart_irrigation.brd, smart_irrigation.sch]
2016-03-23 PCB: Add raindrop sensor
    [smart_irrigation.brd, smart_irrigation.sch]
2016-03-23 PCB: Add caps across BL600 power input
    [smart_irrigation.brd, smart_irrigation.sch]
2016-03-23 PCB: Add solenoid and flow sensor
    [smart_irrigation.brd, smart_irrigation.sch]
2016-03-24 PCB: Add transistor to toggle sensors
    [smart_irrigation.brd, smart_irrigation.sch]
2016-03-24 PCB: Initial board layout
    [smart_irrigation.brd, smart_irrigation.sch]
2016-03-24 PCB: Reposition all sensor headers near edge
    Since headers will have cables running off into the sensors themselves
    (aside from temp), their respective headers should be at the edges of
    the board. The raindrop sensor, however, is a breakout board itself with
    its own header, so it has been placed so that its external header is
    facing the edge of the board as well.
    [smart_irrigation.brd, smart_irrigation.sch]
2016-03-24 PCB: Approve ERC warnings/errors
    [smart_irrigation.brd, smart_irrigation.sch]
2016-03-24 PCB: Give names to all signals.
    [smart_irrigation.brd, smart_irrigation.sch]
2016-03-25 RTC driver and Analog drivers
2016-03-30 PCB: Fix spacing between headers on BL600 package
    [smart_irrigation.brd, smart_irrigation.sch]
2016-03-30 PCB: Change flow sensor GPIO pin
    The flow sensor's pin was on the opposite side of the other sensors,
    making for awkward routing.
    [smart_irrigation.brd, smart_irrigation.sch]
2016-03-30 PCB: Move terminal block farther into board
    [smart_irrigation.brd]
2016-03-30 PCB: Add reset button
    [smart_irrigation.brd, smart_irrigation.sch]
2016-03-31 PCB: Change sensor pin assignments
    All digital sensor outputs are now in one cluster and all analog sensor
    outputs are in another cluster.
    [smart_irrigation.brd, smart_irrigation.sch]
2016-03-31 Changed GPIO pin locations to match new schematic
2016-03-31 Add simple rain drop sensor driver with both analog and digital outputs
2016-03-31 Add info on I2C functions
2016-04-01 Replace hardcoded pin definitions with macros
2016-04-01 Remove extraneous temperature sensing file
2016-04-02 Convert temperature code into function
2016-04-02 Convert raindrop sensor code into functions
2016-04-08 CC article on Transformers & Wall Warts
    This article is from Circuit Cellar magazine. It has a discussion on the circuitry in transformer-based wall warts. The article also mentions that the move is away from transformers to converters in the wall warts
2016-04-15 PCB: Change SENSORS_ENABLE signal pin
    The BL600 breakout board includes SIO_26 and SIO_27, but they're
    reserved and unusable for some reason. SENSORS_ENABLE was thus changed
    from SIO_27 to SIO_25.
    [smart_irrigation.brd, smart_irrigation.sch]
2016-04-15 PCB: Ground VBAT pin of RTC
    Per datasheet, if VBAT is unused, it must be grounded.
    [smart_irrigation.brd, smart_irrigation.sch]
2016-04-15 PCB: Increase isolation from ground plane
    [smart_irrigation.brd]
2016-04-16 PCB: Reroute SDA and RTC_DATA lines
    They were precariously placed so that shorts could occur.
    [smart_irrigation.brd]
2016-04-16 PCB: Rename RTC_DATA to RTC_SQW
    The signal is actually a square wave, not any sort of data.
    [smart_irrigation.brd, smart_irrigation.sch]
2016-04-23 PCB: Move solenoid terminal block away from MOSFET
    [smart_irrigation.brd, smart_irrigation.sch]
2016-04-23 Remove old MOSFET test code
2016-04-24 PCB: Remove old schematic
    [Design_Schematic.sch]
2016-04-26 Sample sensors and write to their characteristics
2016-04-27 App: Add button to display temperature sensor data
    Soon the button will display all of the sensor data.
2016-04-28 App: Add ability to read all sensors
2016-04-28 App: Add flood button
2016-04-28 Add flood function stub
    When flood signal received from phone, the flood function is called.
    Currently a stub.
2016-04-28 Add flow signal to irrigate()
    When irrigate() turns the water on, it updates a characteristic so that
    the phone can see at any time if water is flowing. The signal is turned
    off when the water is turned off.
2016-04-28 App: Add text that tells whether water is flowing
2016-04-29 App: Add button for reading config values
    Previously the phone could only write config values, but it's
    advantageous to also be able to read the pre-existing configuration
    values.
2016-04-29 App: Change "GET" button to "Auto"
    The word "Get" was deceiving and might lead one to believe that its
    purpose was to get the value from the characteristic.
2016-04-29 App: Increase font size of config buttons
2016-04-29 App: Remove old menu code
    The menu used to have the Scan activity, but it was moved to the main
    activity, so the menu references were no longer needed.
    [MainActivity.java]
2016-04-29 App: Rename buttons to be more explanatory
2016-05-02 Add historical data array with write and clear functions. Improved behavior of timer handlers.
2016-05-02 Initial correction to temperature conversion.
2016-05-02 Remove temperature test calls.
2016-05-02 Correct temperature conversion. Tested in refridgerator and room temp with calibrated thermometer.
2016-05-02 Added Config
    [smart_irrigation.brd, timeline.ods]
2016-05-03 App: Remove unused area unit choices
    Area can be only entered in as either square meters or square feet
    because anything smaller doesn't make sense for the irrigation
    algorithm. The area is always written to the characteristic as square
    meters, however, and so it is converted first if entered as square feet.
    The smallest allowable area is 1 square meter and anything smaller will
    be rounded up to 1.
    [MainActivity.java]
2016-05-08 App: Add history download button
2016-05-09 Add ability to download stored data onto phone
    The phone is able to alert the device that it wishes to download any
    stored data with the History Signal characteristic. When the device
    receives that signal it begins to write data to the History
    characteristic (if any such data exists). The phone is alerted when that
    characterisitc has been updated via the Indicate property and it writes
    the data to a timestamped CSV file. The device gets alerted that the
    phone has read the data and it writes another piece to the
    characteristic. This happens until all data has been stored by the
    phone.
2016-05-10 Start timers in globalConfig()
    It didn't make sense to start the timers if there was no configuration
    data present.
2016-05-10 App: Display size of dataArray (in # of days)
    When "Read Sensors" is clicked, the "History" field is updated. "Read
    Sensors" button was chosen due to lack of space for a new button
    (and to avoid more clutter).
    [MainActivity.java]
2016-05-10 App: Fix pre-discovery crash
    If a read of a characteristic was attempted before all of the
    characteristics had been discovered then the app would crash,
    so a flag was added that is set to True after service discovery
    and set to False when disconnected.
    [MainActivity.java]
2016-05-10 Make history size characteristic notifiable
    The phone will now automatically update its display of how many
    days of history are available for downloading, rather than manually
    reading it. The location of the size has also been moved to the Download
    History button itself.
2016-05-13 Correct i2c read errors.
2016-05-13 Correct eto and flow values due to improper latitude and rotation conversion.
2016-05-13 App: Read last sampled sensor values after connect
2016-05-14 App: Read Sensors button signals to update sensors
    Previously the Read Sensors button would just get the sample values from
    the last hourly sampling, but it's more useful to be able to get
    current sensor values whenever you want.
2016-05-16 The app now can query temperature directly. ble.sb sample function performs updates to ble characteristics so doing so in timers.sb is no longer necessary/desired.
2016-05-16 Close i2c handle upon successful reads.
2016-05-18 Solid Works Box Parts
    [Bottom.SLDPRT, Box.SLDASM, Cable.SLDPRT, Divider.DXF, Divider.SLDPRT, Gasket.DXF, Gasket.SLDPRT, LongSidePower.DXF]
2016-05-21 New Box Design
    [BOX.SLDASM, Bottom.SLDPRT, FlowSide.SLDPRT, Gasket.SLDPRT, LongSide.SLDPRT, PowerSide.SLDPRT, Top.SLDPRT]
2016-05-24 Updated Parts - Not Power Side
    [BOX.SLDASM, FlowSide.SLDPRT, Gasket.SLDPRT, PowerSide.SLDPRT, Spacer.SLDPRT, Top.SLDPRT]
2016-05-24 More Box Updates
    [BOX.SLDASM, PowerSide.DXF, PowerSide.SLDPRT]
2016-05-29 Rename main.sb to be autorun-able
    The BL600 will automatically run any program at boot if its name is
    prepended with "$autorun$" and the AUTORUN pin is set LOW.
    The device should automatically start its routine at boot so it must be
    renamed.
2016-05-29 Clean up documents
    [BOX.SLDASM, Bottom.SLDPRT, Box.SLDASM, Cable.SLDPRT, Divider.DXF, Divider.SLDPRT, FlowSide.SLDPRT, Gasket.DXF]
2016-06-03 Added LED Support
